robrec/RePeter/Documentation/RF/HT-RA62-Pinmap.png

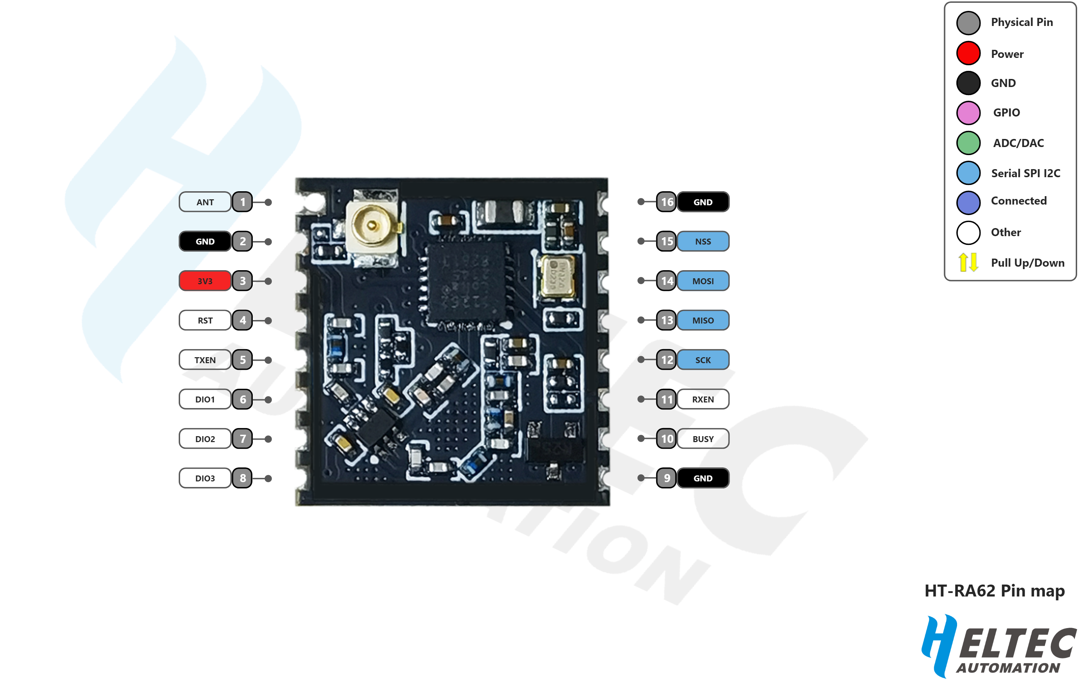
Documentation/RF/HT-RA62-Pinmap.png
