robrec/RePeter/images/RePeterV1_2_Back.png

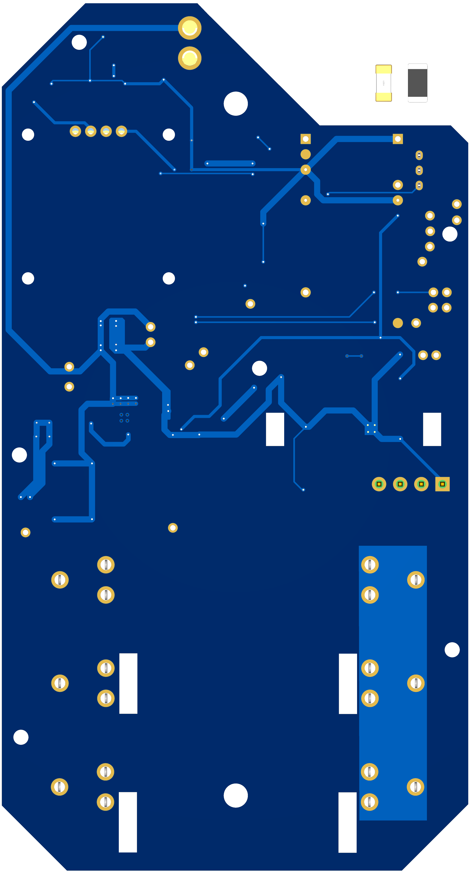
images/RePeterV1_2_Back.png
