robrec/RePeter/images/RePeterV1_2_Front.png

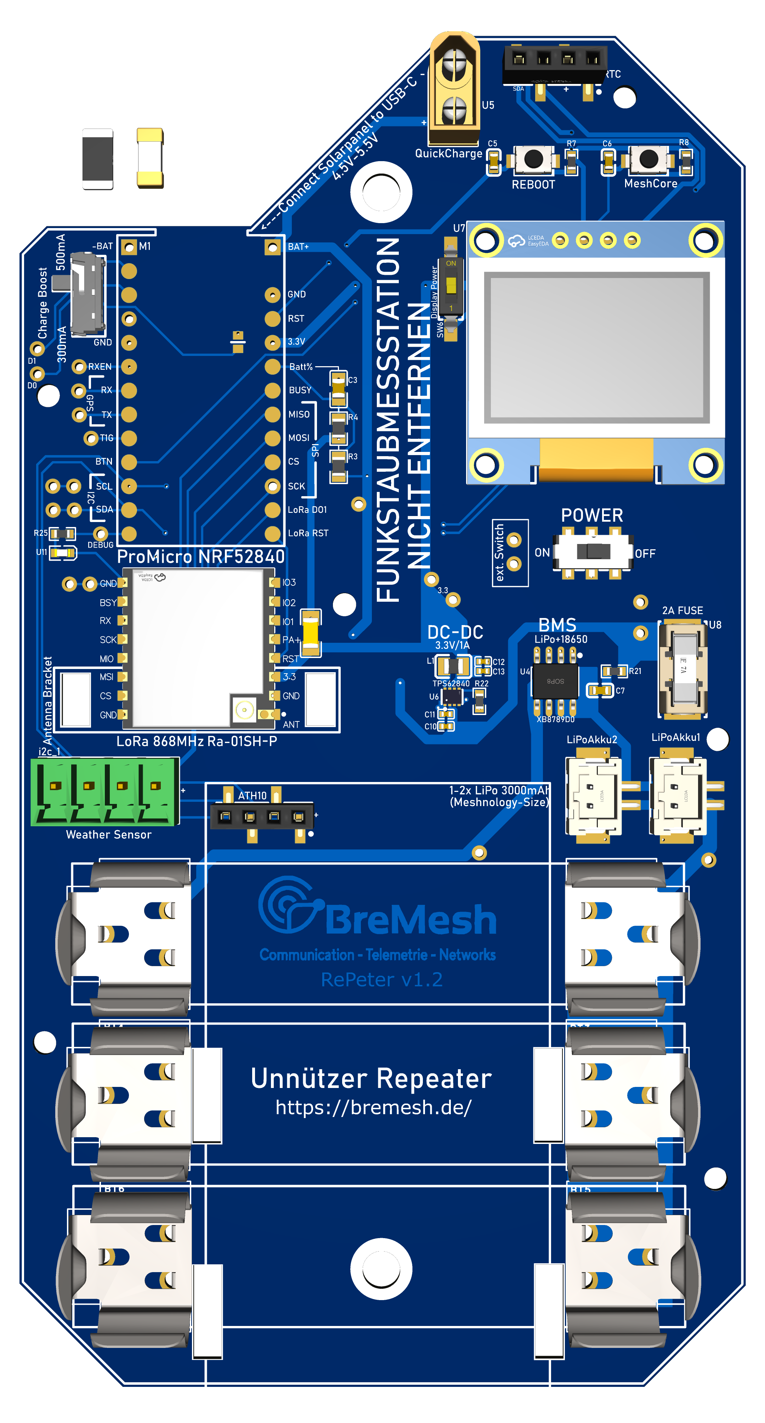
images/RePeterV1_2_Front.png
