robrec/RePeter/images/RePeterV1_2_Front_box.png

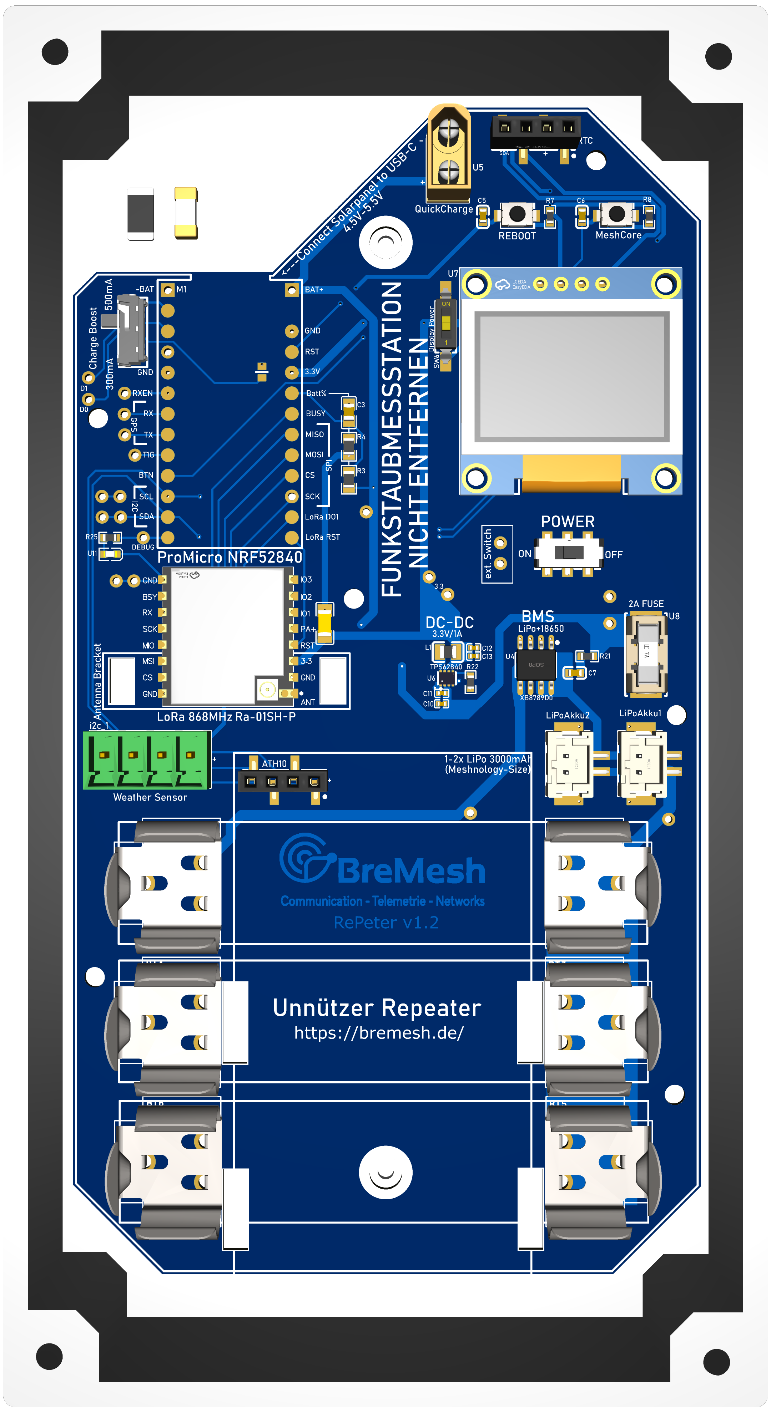
images/RePeterV1_2_Front_box.png
