robrec/RePeter/images/RePeterV1_2_PCBEDITOR.PNG

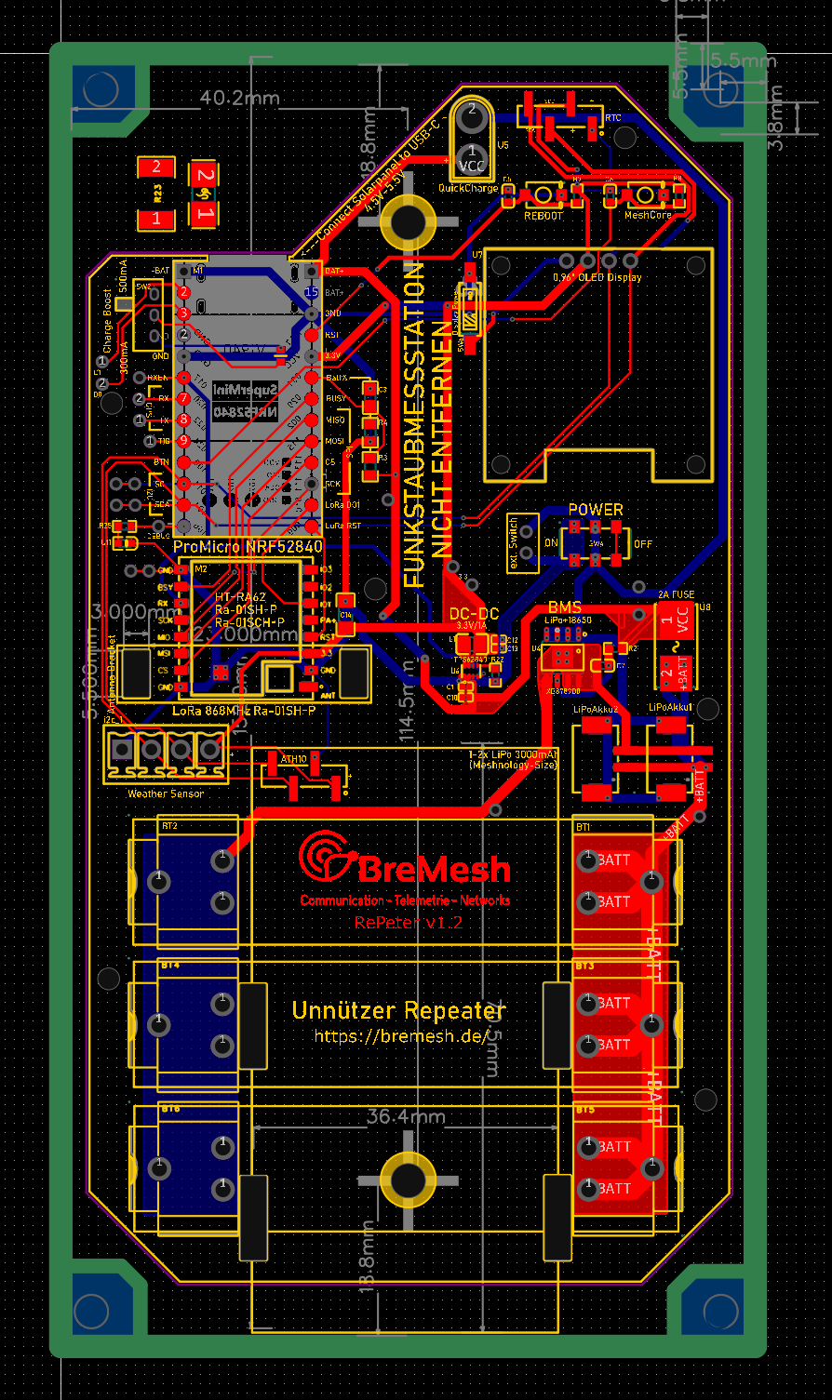
images/RePeterV1_2_PCBEDITOR.PNG
