robrec/RePeter/RePeter_NameTag/RePeter_NameTag_boardV1.PNG

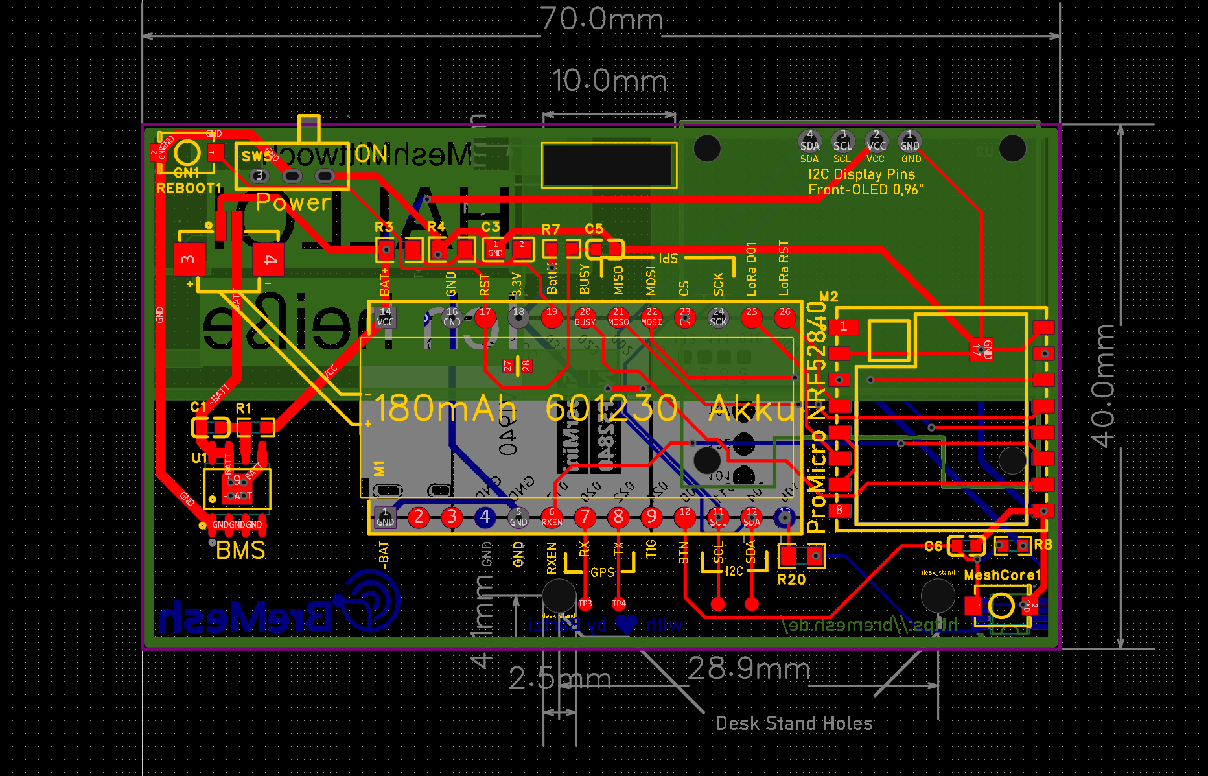
RePeter_NameTag/RePeter_NameTag_boardV1.PNG
