robrec/RePeter/RePeterV1.2/BOM_RePeter_V1.2_FINISHED_RePeterV1.2_2026-01-05.xlsx

No. | Quantity | Comment | Designator | Footprint | Value | Manufacturer Part | Manufacturer | Supplier Part | Supplier
1 | 2 | HX PM2.54-1x4P TP H8.5-YQ | ATH10,RTC | HDR-SMD_4P-P2.54_HX-PM2.54-1X4P-TP-H8.5-YQ |  | HX PM2.54-1x4P TP H8.5-YQ | hanxia(韩下) | C46635840 | LCSC
2 | 6 | MY-18650-01 | BT1,BT2,BT3,BT4,BT5,BT6 | BAT-TH_MY-18650-01 |  | MY-18650-01 | MYOUNG(美阳) | C2979183 | LCSC
3 | 1 | 100nF | C3 | C0805 | 100nF | 0805B104J500NT | FH(风华) | C29926 | LCSC
4 | 3 | 100nF | C5,C6,C7 | C0603 | 100nF | CL10B104KB8NNNC | SAMSUNG(三星) | C1591 | LCSC
5 | 2 | 10uF | C10,C11 | C0402 | 10uF | GRM155R60J106ME15D | muRata(村田) | C412251 | LCSC
6 | 2 | 22uF | C12,C13 | C0402 | 22uF | GRM155R60J226ME11D | muRata(村田) | C415703 | LCSC
7 | 1 | 220uF | C14 | C1206 | 220uF | GRM31CC80G227ME11L | muRata(村田) | C711039 | LCSC
8 | 1 | WJ15EDGVC-3.5-4P | i2c_1 | CONN-TH_WJ15EDGVC-3.5-4P |  | WJ15EDGVC-3.5-4P | KANGNEX(康奈克斯电气) | C5241856 | LCSC
9 | 1 | 2.2uH | L1 | L0806 | 2.2uH | DFE201612E-2R2M=P2 | muRata(村田) | C337893 | LCSC
10 | 2 | PH2.0-2P-LT | LiPoAkku1,LiPoAkku2 | CONN-SMD_PH2.0-1X2PW |  | PH2.0-2P-LT | CAX(创都) | C722761 | LCSC
11 | 1 | ProMicro_nRF52840 | M1 | ProMicro_NRF52840
12 | 1 | Ra-01SH-P/HT-RA62 | M2 | WIRELM-SMD_RA-01SCH-P |  | Ra-01SH-P/HT-RA62 | Ai-Thinker(安信可) | C41368034 | LCSC
13 | 2 | Button | MeshCore,REBOOT | SW-SMD_L3.9-W3.0-P4.45 |  | TS-1088-AR02016 | XUNPU(讯普) | C720477 | LCSC
14 | 2 | 1MΩ | R3,R4 | R0805 | 1MΩ | RT0805BRD071ML | YAGEO(国巨) | C706228 | LCSC
15 | 2 | 10kΩ | R7,R8 | R0603 | 10kΩ | 0603WAF1002T5E | UNI-ROYAL(厚声) | C25804 | LCSC
16 | 1 | 100Ω | R21 | R0603 | 100Ω | RC0603FR-07100RL | YAGEO(国巨) | C105588 | LCSC
17 | 1 | 267kΩ | R22 | R0603 | 267kΩ | 0603WAF2673T5E | UNI-ROYAL(厚声) | C22963 | LCSC
18 | 1 | 0Ω | R23 | RES-SMD_L6.4-W3.2-JER2512XXXXXX | 0Ω | JER2512F3R000 | JIERR(捷而瑞) | C49164931 | LCSC
19 | 1 | 30Ω | R25 | R0603 | 30Ω | 0603WAF300JT5E | UNI-ROYAL(厚声) | C22985 | LCSC
20 | 1 | MK-12D18-G040 | SW2 | SW-TH_MK-12D18-G040 |  | MK-12D18-G040 | G-Switch(品赞) | C963202 | LCSC
21 | 1 | SSSS213202 | SW4 | SW-TH_SSSS213202 |  | SSSS213202 | ALPSALPINE(阿尔卑斯阿尔派) | C115375 | LCSC
22 | 1 | DSIC01LSGET | SW6 | SW-SMD_DSIC01LSGET |  | DSIC01LSGET | YE | C54948 | LCSC
23 | 1 | XB8789D0 | U4 | SOP-8_L4.9-W3.9-P1.27-LS6.0-BL-EP |  | XB8789D0 | xysemi(赛芯微) | C85055 | LCSC
24 | 1 | XT30U-M | U5 | CONN-TH_XT30U-M |  | XT30U-M | AMASS(艾迈斯) | C99101 | LCSC
25 | 1 | TPS62840DLCR | U6 | VSON-8_L2.0-W1.5-P0.50-BL |  | TPS62840DLCR | TI(德州仪器) | C2071859 | LCSC
26 | 1 | HS96L03W2C03 | U7 | OLED-TH_L27.8-W27.2-P2.54_C9900033791 |  | HS96L03W2C03 | HS(汉昇) | C5248080 | LCSC
27 | 1 | 01550900M | U8 | FUSE-SMD_L9.8-W5.0_01550900M |  | 01550900M | Littelfuse(美国力特) | C108518 | LCSC
28 | 1 | 0451002.MRL | U9 | FUSE-SMD_L6.1-W2.7 |  | 0451002.MRL | Littelfuse(美国力特) | C99547 | LCSC
29 | 1 | PSC-1608U52GC-G4 | U11 | LED0603-RD_GREEN |  | PSC-1608U52GC-G4 | HONGLITRONIC(鸿利光电) | C22371297 | LCSC
