robrec/RePeter/RePeter_NameTag/BOM_RePeter_NameTag_RePeter_NameTag_V1_2025-12-26.xlsx

No. | Quantity | Comment | Designator | Footprint | Value | Manufacturer Part | Manufacturer | Supplier Part | Supplier
1 | 1 | 100nF | C1 | C0603 | 100nF | CC0603KRX7R9BB104 | YAGEO(国巨) | C14663 | LCSC
2 | 1 | 100nF | C3 | C0805 | 100nF | 0805B104J500NT | FH(风华) | C29926 | LCSC
3 | 2 | 100nF | C5,C6 | C0603 | 100nF | CL10B104KB8NNNC | SAMSUNG(三星) | C1591 | LCSC
4 | 1 | HC-1.25-2PWT | CN1 | CONN-SMD_2P-P1.25-HC-1.25-2PWT |  | HC-1.25-2PWT | HCTL(华灿天禄) | C2845379 | LCSC
5 | 1 | ProMicro_nRF52840 | M1 | ProMicro_NRF52840
6 | 1 | Ra-01SH-P/HT-62 | M2 | WIRELM-SMD_RA-01SCH-P |  | Ra-01SH-P/HT-62 | Ai-Thinker(安信可) | C41368034 | LCSC
7 | 2 | Button | MeshCore1,REBOOT1 | SW-SMD_L3.9-W3.0-P4.45 |  | TS-1088-AR02016 | XUNPU(讯普) | C720477 | LCSC
8 | 1 | 100Ω | R1 | R0603 | 100Ω | RC0603FR-07100RL | YAGEO(国巨) | C105588 | LCSC
9 | 2 | 1MΩ | R3,R4 | R0805 | 1MΩ | RT0805BRD071ML | YAGEO(国巨) | C706228 | LCSC
10 | 2 | 10kΩ | R7,R8 | R0603 | 10kΩ | 0603WAF1002T5E | UNI-ROYAL(厚声) | C25804 | LCSC
11 | 1 | 5kΩ | R20 | R0805 | 5kΩ | ARG05DTC5001 | Viking(光颉) | C2828783 | LCSC
12 | 1 | MK-12D18-G040 | SW5 | SW-TH_MK-12D18-G040 |  | MK-12D18-G040 | G-Switch(品赞) | C963202 | LCSC
13 | 1 | XB8789D0 | U1 | SOP-8_L4.9-W3.9-P1.27-LS6.0-BL-EP |  | XB8789D0 | xysemi(赛芯微) | C85055 | LCSC
14 | 1 | HS96L03W2C03 | U2 | OLED-TH_L27.8-W27.2-P2.54_C9900033791 |  | HS96L03W2C03 | HS(汉昇) | C5248080 | LCSC
15 | 1 | DS18B20A | U3 | MSOP-8_L3.0-W3.0-P0.65-LS4.9-BR |  | DS18B20A | KTP(科泰普) | C48392933 | LCSC
