robrec/RePeter/RePeter_Tools/ProMicro_ChargeBoard/BOM_USB-C_Adapter_USB-C_RePeter_V1.xlsx

No. | Quantity | Comment | Designator | Footprint | Value | Manufacturer Part | Manufacturer | Supplier Part | Supplier
1 | 1 | PH2.0-2P-LT | JST2.0 | CONN-SMD_PH2.0-1X2PW |  | PH2.0-2P-LT | CAX(创都) | C722761 | LCSC
2 | 1 | TYPEC-303-ACP16 | Solar/Flash | USB-C-SMD_TYPEC-303-ACP16 |  | TYPEC-303-ACP16 | XUNPU(讯普) | C720628 | LCSC
3 | 1 | TC-003LS | toRePeter | USB-C-SMD_TC-003LS |  | TC-003LS | HANBO(汉博) | C6332258 | LCSC
