robrec/RePeter/RePeterV1.2/RePeterV1.2_schematic.pdf

# BUSY 10 RF_EN 11 SCK 12 MISO 13 MOSI 14 NSS 15 GND 16 GND 17

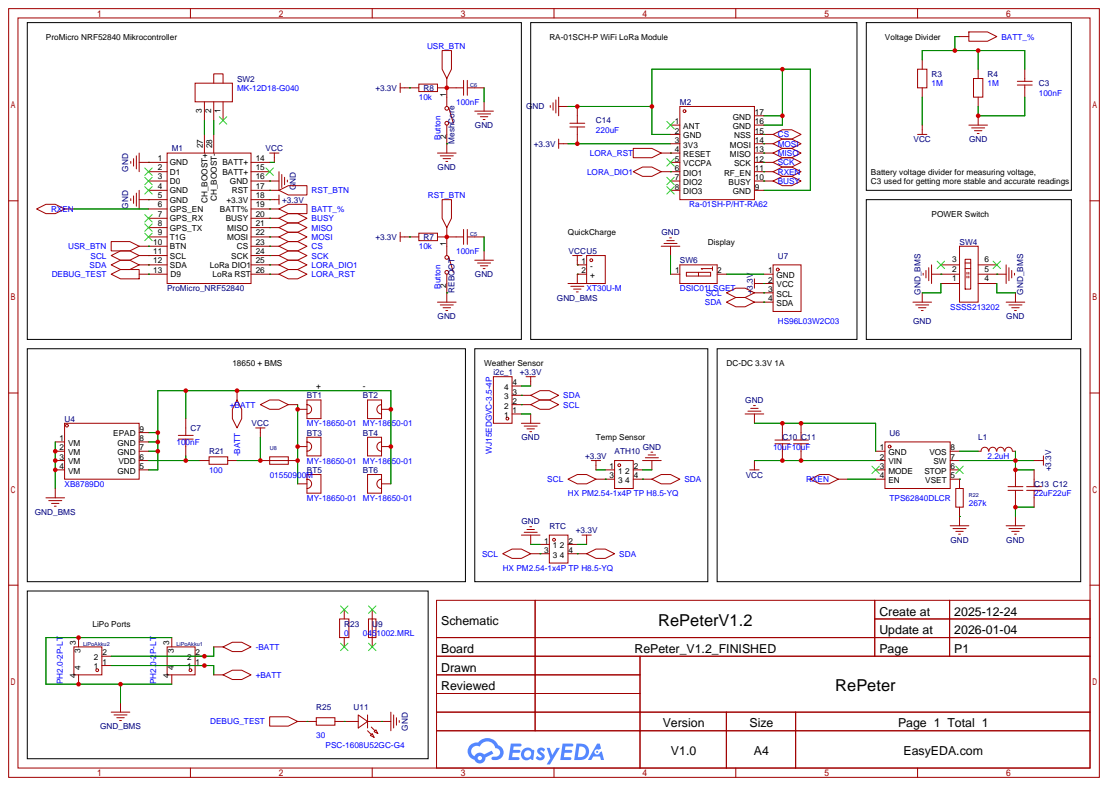
[picture p19: page 1]

Battery voltage divider for measuring voltage,
C3 used for getting more stable and accurate readings

Schematic | RePeterV1.2 | Create at | 2025-12-24

Update at | 2026-01-04

Drawn | RePeter
Reviewed

Version | Size | Page 1 Total 1
V1.0 | A4 | EasyEDA.com
