robrec/RePeter/Documentation/RF/HT-RA62_Reference_design.pdf

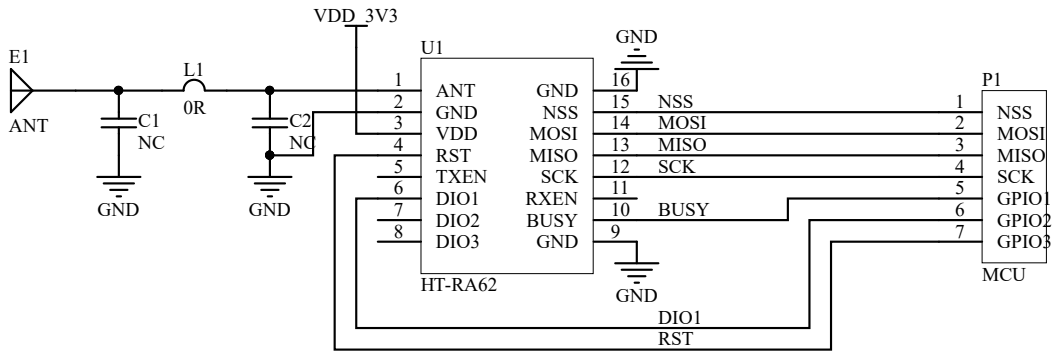
[picture p20: page 1]

NC | | 3 | | 9 BUSY 10 RXEN 11 SCK 12 MISO 13 MOSI 14 NSS 15 GND 16 MOSI 2

4 | | MISO 3
5 | | SCK 4

7 | | BUSY | 6

DIO1 | 7
