robrec/RePeter/Documentation/RF/HT-RA62_Schematic_diagram.pdf

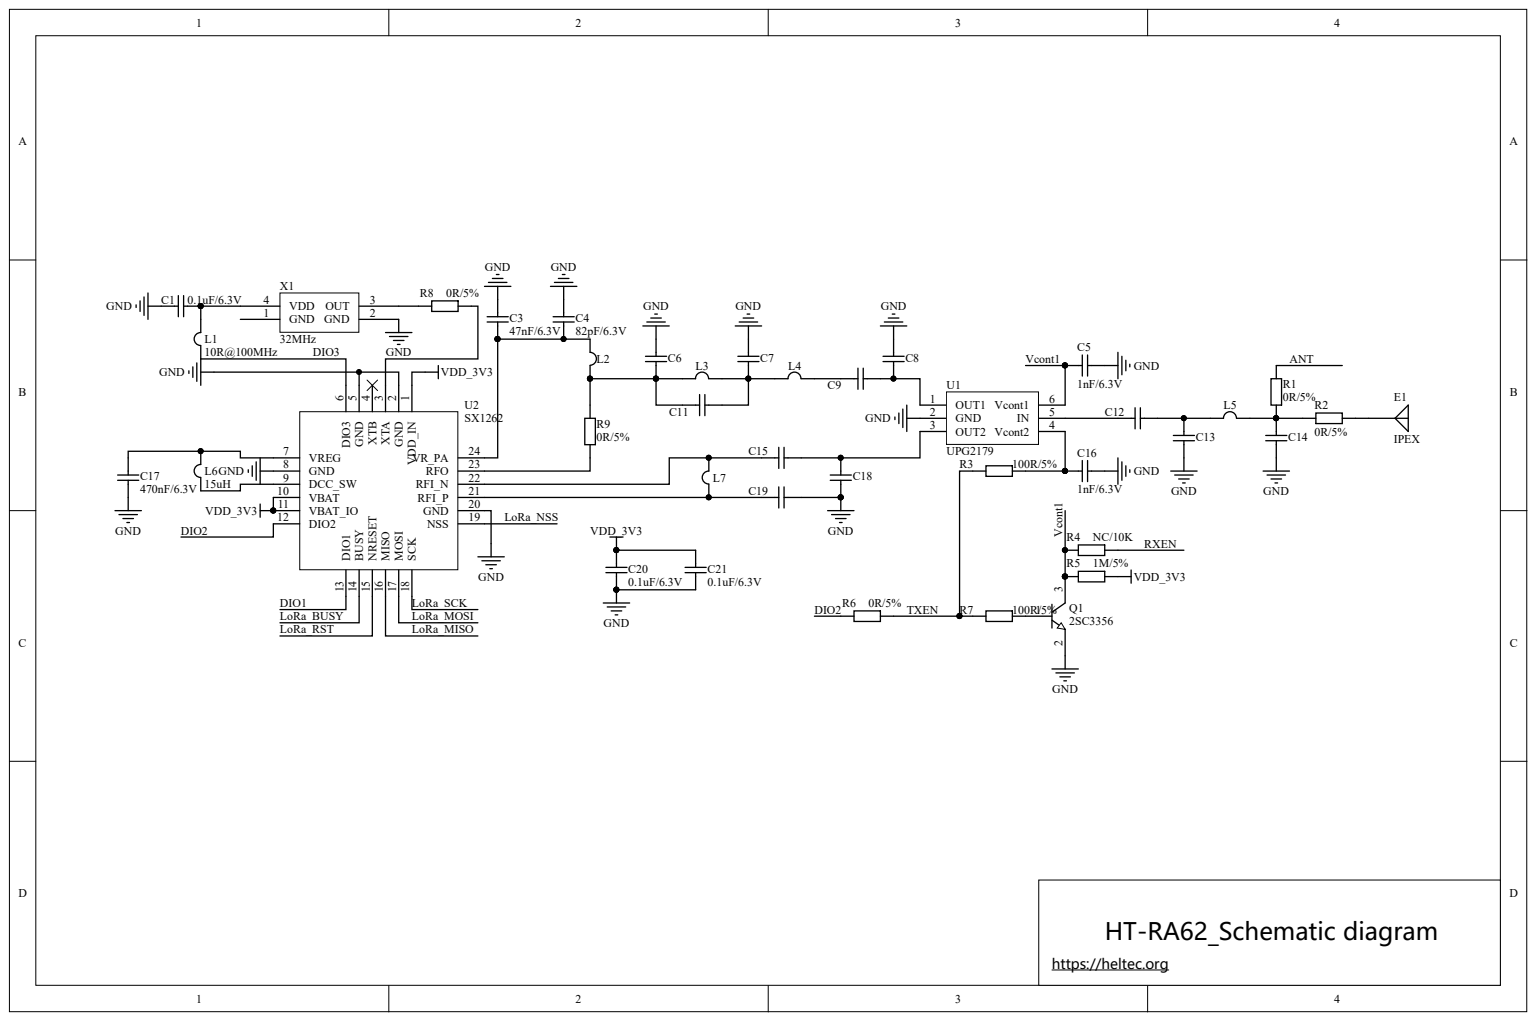
[picture p21: page 1]

VDD_IN 1 GND 2 XTA 3 XTB 4 GND 5 DIO3 6

GND 8 | | L7

VBAT 10 | | C19

DIO1 | | | LoRa_SCK
LoRa_BUSY | | LoRa_MOSI
LoRa_RST | LoRa_MISO
