robrec/RePeter/RePeter_NameTag/SCH_RePeter_NameTag_V1_2025-12-26.pdf

# BUSY 10 RF_EN 11 SCK 12 MISO 13 MOSI 14 NSS 15 GND 16 GND 17

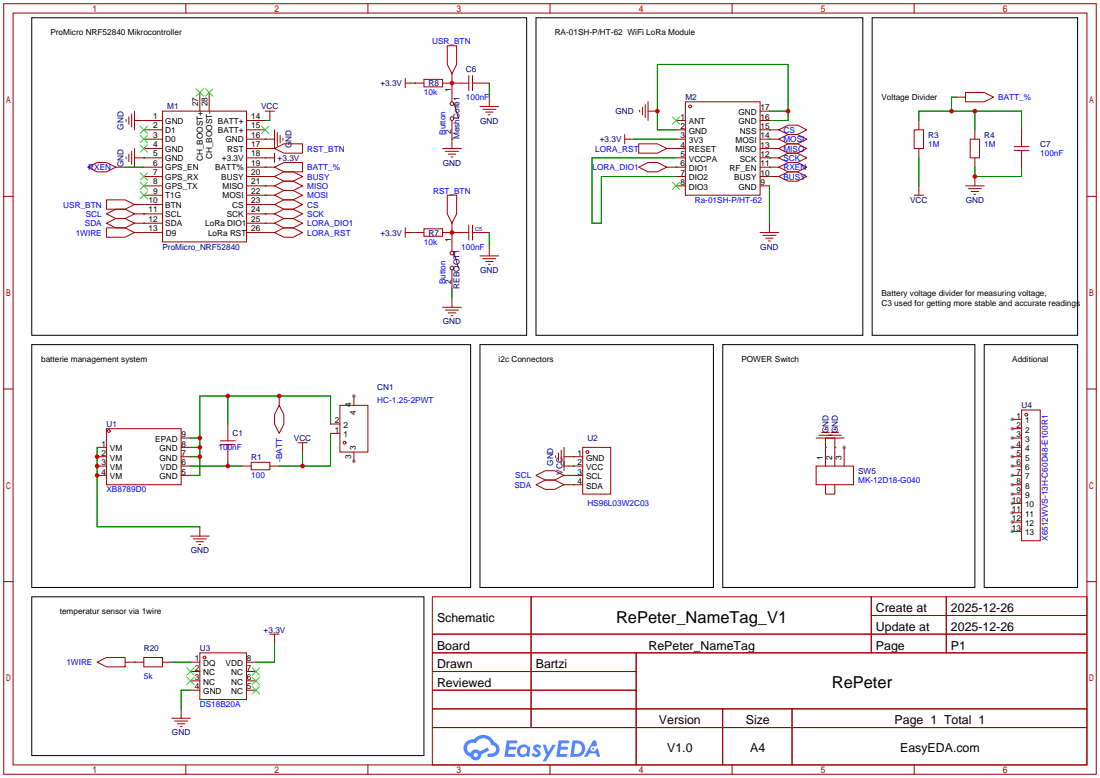
[picture p22: page 1]

Battery voltage divider for measuring voltage,
C3 used for getting more stable and accurate readings

Schematic | RePeter_NameTag_V1 | Create at | 2025-12-26

Update at | 2025-12-26

Board | RePeter_NameTag | Page | P1
Drawn | Bartzi | RePeter
Reviewed

Version | Size | Page 1 Total 1
V1.0 | A4 | EasyEDA.com
