robrec/RePeter/RePeter_Tools/ProMicro_ChargeBoard/SCH_USB-C_RePeter_V1.pdf

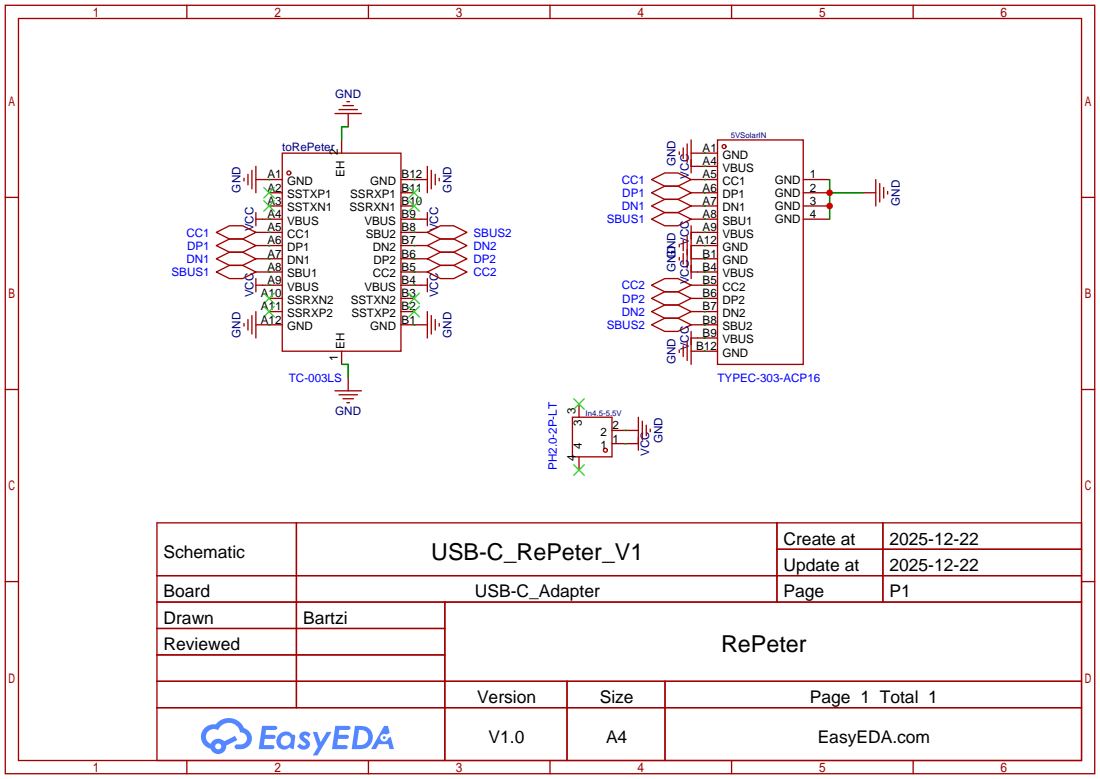
[picture p23: page 1]

GND GND

Schematic | USB-C_RePeter_V1 | Create at | 2025-12-22

Update at | 2025-12-22

Board | USB-C_Adapter | Page | P1
Drawn | Bartzi | RePeter
Reviewed

Version | Size | Page 1 Total 1
V1.0 | A4 | EasyEDA.com
