robrec/RePeter/scripte/PubKeySearcher/key_searcher.py

#!/usr/bin/env python3
"""
BreMesh MeshCore PubKey Searcher
Searches for ed25519 Public Keys with special patterns at the start (HEX)
Utilizes all available CPU cores for maximum performance
"""

import os
import sys
import multiprocessing as mp
import argparse
from datetime import datetime
from pathlib import Path
from typing import Set
import json
import threading
import time

try:
    from cryptography.hazmat.primitives.asymmetric import ed25519
    from cryptography.hazmat.primitives import serialization
    from rich.console import Console, Group
    from rich.panel import Panel
    from rich.table import Table
    from rich.progress import Progress, BarColumn, TextColumn, TaskProgressColumn
    import psutil
except ImportError as e:
    print(f"ERROR: Required library not installed: {e}")
    print("Please install with: pip install cryptography rich psutil")
    exit(1)


class KeySearcher:
    def __init__(self, patterns_file: str = "searchFor.txt", output_dir: str = "found_keys", max_pattern_length: int = 7, single_pattern: str = None, verbose: bool = False):
        self.single_pattern_mode = single_pattern is not None
        self.verbose = verbose
        self.patterns_file = patterns_file  # Store for hot-reload
        if single_pattern:
            self.patterns = {single_pattern.upper()}
            print(f"Searching for single pattern: {single_pattern.upper()}")
        else:
            self.patterns = self.load_patterns(patterns_file)
            print(f"Loaded Patterns: {len(self.patterns)}")
        
        self.output_dir = Path(output_dir)
        self.output_dir.mkdir(exist_ok=True)
        self.max_pattern_length = max_pattern_length
        self.stats_file = Path(".total_stats.json")
        self.total_all_time = self.load_total_stats()
        
        print(f"Output Directory: {self.output_dir.absolute()}")
        print(f"Max Pattern Length for Duplicate Prevention: {self.max_pattern_length}")
        print(f"Total Keys Checked All-Time: {self.total_all_time:,}")
    
    def load_patterns(self, filename: str) -> Set[str]:
        """Loads patterns from file"""
        patterns = set()
        try:
            with open(filename, 'r', encoding='utf-8') as f:
                for line in f:
                    line = line.strip()
                    if line and not line.startswith('#'):
                        patterns.add(line)
        except FileNotFoundError:
            print(f"ERROR: {filename} not found!")
            exit(1)
        return patterns
    
    def load_total_stats(self) -> int:
        """Loads total all-time key count from stats file"""
        try:
            if self.stats_file.exists():
                with open(self.stats_file, 'r', encoding='utf-8') as f:
                    data = json.load(f)
                    return data.get('total_keys_checked', 0)
        except Exception:
            pass
        return 0
    
    def save_total_stats(self, total_keys: int) -> None:
        """Saves total all-time key count to stats file"""
        try:
            data = {
                'total_keys_checked': self.total_all_time + total_keys,
                'last_updated': datetime.now().isoformat()
            }
            with open(self.stats_file, 'w', encoding='utf-8') as f:
                json.dump(data, f, indent=2)
        except Exception:
            pass
    
    @staticmethod
    def format_number(num: int) -> str:
        """Format number with k/M suffix"""
        if num >= 1_000_000:
            return f"{num / 1_000_000:.1f}M"
        elif num >= 1_000:
            return f"{num / 1_000:.1f}k"
        return str(num)
    
    @staticmethod
    def format_time(seconds: float) -> str:
        """Format seconds to readable time string"""
        if seconds < 60:
            return f"{int(seconds)}s"
        elif seconds < 3600:
            return f"{int(seconds / 60)}m"
        elif seconds < 86400:
            return f"{seconds / 3600:.1f}h"
        elif seconds < 31536000:
            return f"{seconds / 86400:.1f}d"
        return f"{seconds / 31536000:.1f}y"
    
    @staticmethod
    def estimate_time(pattern_length: int, keys_per_sec: int) -> str:
        """Estimate time to find a pattern of given length"""
        if keys_per_sec == 0:
            return "N/A"
        possibilities = 16 ** pattern_length
        seconds = possibilities / keys_per_sec
        return KeySearcher.format_time(seconds)
    
    @staticmethod
    def display_process(display_queue, total_all_time, start_time, num_workers, pause_event, cpu_limit_event, startup_info):
        """Dedicated process for displaying live statistics using Rich Live"""
        from rich.live import Live
        
        console = Console()
        last_total = 0
        last_found = 0
        found_keys_list = []
        is_paused = False
        # Track found patterns by length category - start with existing counts
        found_by_len = {k: v for k, v in startup_info['existing_counts'].items()}
        # Track remaining pattern lengths for ETA calculation
        remaining_lengths = list(startup_info['remaining_pattern_lengths'])
        last_find_time = start_time  # Time of last found key (or start)
        
        def build_panel():
            """Build the combined stats panel"""
            nonlocal is_paused
            is_paused = not pause_event.is_set()
            
            elapsed = max(0.1, datetime.now().timestamp() - start_time)
            cpu_percent = psutil.cpu_percent(interval=0.1)
            keys_per_sec = int(last_total / elapsed) if elapsed > 0 else 0
            all_time_total = total_all_time + last_total
            
            content = Table.grid(padding=(0, 2))
            content.add_column(justify="right", style="bright_cyan")
            content.add_column(justify="left", style="bright_white")
            content.add_column(justify="right", style="bright_cyan")
            content.add_column(justify="left", style="bright_white")
            
            # Config section
            is_cpu_limited = cpu_limit_event.is_set()
            workers_text = f"[bold cyan]{num_workers}[/bold cyan]"
            if is_cpu_limited:
                workers_paused = max(1, int(num_workers * 0.25))
                workers_active = num_workers - workers_paused
                workers_text = f"[bold cyan]{num_workers}[/bold cyan] [dim yellow](Limit: {workers_active})[/dim yellow]"
            
            content.add_row(
                "[bold bright_cyan]Patterns:[/bold bright_cyan]", f"[bold green]{startup_info['num_patterns']}[/bold green]",
                "[bold bright_cyan]Workers:[/bold bright_cyan]", workers_text
            )
            if startup_info['existing_patterns']:
                content.add_row(
                    "[bold bright_cyan]Already Found:[/bold bright_cyan]", f"[bold yellow]{startup_info['num_existing']}[/bold yellow]",
                    "", ""
                )
            content.add_row(
                "[bold bright_cyan]No Dup Cap:[/bold bright_cyan]", f"[dim]>{startup_info['max_pattern_length']} chars[/dim]",
                "", ""
            )
            
            # Separator
            content.add_row("[dim]" + "─" * 40 + "[/dim]", "", "", "")
            
            # Status
            is_cpu_limited = cpu_limit_event.is_set()
            if is_paused:
                status = "[bold yellow]⏸ PAUSED[/bold yellow]"
            else:
                status = "[bold green]▶ RUNNING[/bold green]"
                if is_cpu_limited:
                    workers_paused = max(1, int(num_workers * 0.25))
                    workers_active = num_workers - workers_paused
                    target_pct = int((workers_active / num_workers) * 100)
                    status += f" [dim yellow](CPU ~{target_pct}%)[/dim yellow]"
            content.add_row("[bold bright_cyan]Status:[/bold bright_cyan]", status, "", "")
            
            # Stats
            content.add_row(
                "[bold bright_cyan]Session:[/bold bright_cyan]", f"[bold green]{KeySearcher.format_number(last_total)}[/bold green] keys",
                "[bold bright_cyan]All-Time:[/bold bright_cyan]", f"[bold blue]{KeySearcher.format_number(all_time_total)}[/bold blue] keys"
            )
            content.add_row(
                "[bold bright_cyan]Found:[/bold bright_cyan]", f"[bold yellow]{last_found}[/bold yellow] matches",
                "[bold bright_cyan]Speed:[/bold bright_cyan]", f"[bold magenta]{KeySearcher.format_number(keys_per_sec)}[/bold magenta] keys/s"
            )
            
            # CPU bar with better visuals
            bar_width = 20
            filled = int(cpu_percent / 100 * bar_width)
            bar = "█" * filled + "░" * (bar_width - filled)
            bar_color = "red" if cpu_percent > 80 else ("yellow" if cpu_percent > 50 else "green")
            content.add_row(
                "[bold bright_cyan]Duration:[/bold bright_cyan]", f"[bold white]{KeySearcher.format_time(elapsed)}[/bold white]",
                "[bold bright_cyan]CPU:[/bold bright_cyan]", f"[{bar_color}]{bar}[/{bar_color}] [bold white]{cpu_percent:.0f}%[/bold white]"
            )
            
            # Rarity colors by pattern length
            COLOR_ARTIFACT = "#FF8000"   # 10+ chars - Orange
            COLOR_EPIC = "#A335EE"       # 9 chars - Purple
            COLOR_RARE = "#0070DD"       # 8 chars - Blue
            COLOR_UNCOMMON = "#1EFF00"   # 7 chars - Green
            COLOR_COMMON = "#FFFFFF"     # 6 chars - White
            COLOR_POOR = "#9D9D9D"       # <=5 chars - Gray
            
            # Remaining patterns to find (total and by length)
            # found_by_len already includes existing + session found
            total_found = sum(found_by_len.values())
            remaining = startup_info['num_patterns'] - total_found
            pc = startup_info['pattern_counts']
            # Format: found/total for each category
            fbl = found_by_len
            
            # Estimates section
            content.add_row("", "", "", "")
            content.add_row("[dim]" + "─" * 40 + "[/dim]", "", "", "")
            content.add_row(
                "[bold bright_yellow]Time Estimates:[/bold bright_yellow]", "",
                "[bold bright_cyan]Remaining:[/bold bright_cyan]", f"[bold white]{remaining}[/bold white] patterns"
            )
            content.add_row(
                "[dim]  5 chars:[/dim]", f"[{COLOR_POOR}]{KeySearcher.estimate_time(5, keys_per_sec)}[/{COLOR_POOR}]  [dim]({fbl[5]}/{pc[5]})[/dim]",
                "[dim]  6 chars:[/dim]", f"[{COLOR_COMMON}]{KeySearcher.estimate_time(6, keys_per_sec)}[/{COLOR_COMMON}]  [dim]({fbl[6]}/{pc[6]})[/dim]"
            )
            content.add_row(
                "[dim]  7 chars:[/dim]", f"[{COLOR_UNCOMMON}]{KeySearcher.estimate_time(7, keys_per_sec)}[/{COLOR_UNCOMMON}]  [dim]({fbl[7]}/{pc[7]})[/dim]",
                "[dim]  8 chars:[/dim]", f"[{COLOR_RARE}]{KeySearcher.estimate_time(8, keys_per_sec)}[/{COLOR_RARE}]  [dim]({fbl[8]}/{pc[8]})[/dim]"
            )
            content.add_row(
                "[dim]  9 chars:[/dim]", f"[{COLOR_EPIC}]{KeySearcher.estimate_time(9, keys_per_sec)}[/{COLOR_EPIC}]  [dim]({fbl[9]}/{pc[9]})[/dim]",
                "[dim]  10+ chars:[/dim]", f"[{COLOR_ARTIFACT}]{KeySearcher.estimate_time(10, keys_per_sec)}[/{COLOR_ARTIFACT}]  [dim]({fbl[10]}/{pc[10]})[/dim]"
            )
            
            # Build main panel
            main_panel = Panel(
                content,
                title="[bold bright_white on blue] 🔍 BreMesh MeshCore Ed25519 PubKey Prefix Searcher [/bold bright_white on blue]",
                subtitle="[dim white]Ctrl+C to stop • P to pause • R to resume • L to limit CPU[/dim white]",
                border_style="bright_blue",
                padding=(1, 2)
            )
            
            # Calculate ETA for next key based on remaining patterns
            # Combined probability = sum(1/16^L for each remaining pattern)
            progress_panel = None  # Default: no progress panel
            if keys_per_sec > 0 and remaining_lengths:
                combined_prob = sum(1.0 / (16 ** plen) for plen in remaining_lengths)
                if combined_prob > 0:
                    expected_keys = 1.0 / combined_prob
                    expected_seconds = expected_keys / keys_per_sec
                    time_since_last = datetime.now().timestamp() - last_find_time
                    
                    # Session expected: how many keys should we have found by now?
                    session_elapsed = datetime.now().timestamp() - start_time
                    session_expected_keys = session_elapsed * keys_per_sec * combined_prob
                    
                    # Progress: time since last find / expected time per key
                    # Resets to 0 when a key is found, grows towards 100%
                    progress = (time_since_last / expected_seconds) if expected_seconds > 0 else 0
                    
                    # Bar is capped at 0-100%, but percentage display can go outside
                    bar_progress = max(0.0, min(1.0, progress))
                    
                    # Color changes based on progress
                    if progress < 0.5:
                        bar_color = "bright_cyan"
                    elif progress < 1.0:
                        bar_color = "bright_yellow"
                    else:
                        bar_color = "bright_green"  # Overdue - should find soon!
                    
                    eta_str = KeySearcher.format_time(expected_seconds)
                    elapsed_str = KeySearcher.format_time(time_since_last)
                    percent_str = f"{progress * 100:.0f}%"
                    
                    # Dynamic progress bar - use console width minus panel padding/border
                    terminal_width = console.size.width
                    bar_width = max(20, terminal_width - 8)  # -8 for panel borders and padding
                    filled = int(bar_progress * bar_width)  # Bar capped at 100%
                    
                    # Build progress bar with percentage in the middle
                    center_pos = bar_width // 2 - len(percent_str) // 2
                    bar_chars = []
                    for i in range(bar_width):
                        if i >= center_pos and i < center_pos + len(percent_str):
                            # Character from percent string
                            char_idx = i - center_pos
                            char = percent_str[char_idx]
                            if i < filled:
                                bar_chars.append(f"[bold black on {bar_color}]{char}[/bold black on {bar_color}]")
                            else:
                                bar_chars.append(f"[bold {bar_color}]{char}[/bold {bar_color}]")
                        else:
                            # Bar character
                            if i < filled:
                                bar_chars.append(f"[{bar_color}]█[/{bar_color}]")
                            else:
                                bar_chars.append("[dim]░[/dim]")
                    
                    progress_bar = "".join(bar_chars)
                    
                    # Build per-length ETA timers with rarity colors
                    from collections import Counter
                    len_counts = Counter(remaining_lengths)
                    eta_timers = []
                    # Collect counts for 11+ separately
                    count_11_plus = sum(c for l, c in len_counts.items() if l >= 11)
                    for length in sorted(len_counts.keys()):
                        if length > 10:
                            continue  # Skip individual lengths > 10, handled as 11+
                        count = len_counts[length]
                        if count > 0 and keys_per_sec > 0:
                            prob = count / (16 ** length)
                            eta_secs = 1.0 / (prob * keys_per_sec)
                            # Color based on length
                            if length >= 10:
                                color = COLOR_ARTIFACT
                            elif length == 9:
                                color = COLOR_EPIC
                            elif length == 8:
                                color = COLOR_RARE
                            elif length == 7:
                                color = COLOR_UNCOMMON
                            elif length == 6:
                                color = COLOR_COMMON
                            else:
                                color = COLOR_POOR
                            eta_timers.append(f"[dim]{length}:[/dim][{color}]{KeySearcher.format_time(eta_secs)}[/{color}]")
                    # Add 11+ in red if there are any patterns >= 11
                    if count_11_plus > 0 and keys_per_sec > 0:
                        prob_11 = count_11_plus / (16 ** 11)
                        eta_secs_11 = 1.0 / (prob_11 * keys_per_sec)
                        eta_timers.append(f"[dim]11+:[/dim][bold red]{KeySearcher.format_time(eta_secs_11)}[/bold red]")
                    eta_timers_str = "  ".join(eta_timers) if eta_timers else ""
                    
                    # Progress panel content with expected vs found keys
                    expected_found_str = f"[dim]Session:[/dim] [bold white]{last_found}[/bold white] [dim]/[/dim] [bold yellow]{session_expected_keys:.2f}[/bold yellow]"
                    progress_text = f"[bold bright_magenta]Next Key ETA:[/bold bright_magenta] [bold white]{eta_str}[/bold white]    [dim]Elapsed:[/dim] [dim white]{elapsed_str}[/dim white]    {expected_found_str}    {eta_timers_str}\n{progress_bar}"
                    
                    # Show formula only in verbose mode
                    if startup_info.get('verbose', False):
                        formula_parts = []
                        for length in sorted(len_counts.keys()):
                            count = len_counts[length]
                            formula_parts.append(f"{count}/16^{length}")
                        formula_str = f"[dim]ETA = 1 / (({' + '.join(formula_parts)}) × {KeySearcher.format_number(keys_per_sec)}) = {eta_str}[/dim]"
                        progress_text += f"\n{formula_str}"
                    
                    progress_panel = Panel(
                        progress_text,
                        border_style="bright_magenta",
                        padding=(0, 2)
                    )
                    
                    # Build found keys panel (third panel)
                    if found_keys_list:
                        found_content = Table.grid(padding=(0, 2))
                        found_content.add_column(justify="left")
                        found_content.add_column(justify="left")
                        
                        for pattern, preview in found_keys_list[-5:]:
                            pattern_len = len(pattern)
                            # Rarity indicators based on pattern length
                            if pattern_len >= 11:
                                symbol = "[bold red]***[/bold red]"
                                pattern_style = "[bold red]"
                                end_style = "[/bold red]"
                            elif pattern_len >= 10:
                                symbol = f"[{COLOR_ARTIFACT}]**[/{COLOR_ARTIFACT}]"
                                pattern_style = f"[bold {COLOR_ARTIFACT}]"
                                end_style = f"[/bold {COLOR_ARTIFACT}]"
                            elif pattern_len >= 9:
                                symbol = f"[{COLOR_EPIC}]*[/{COLOR_EPIC}]"
                                pattern_style = f"[bold {COLOR_EPIC}]"
                                end_style = f"[/bold {COLOR_EPIC}]"
                            elif pattern_len >= 8:
                                symbol = f"[{COLOR_RARE}]+[/{COLOR_RARE}]"
                                pattern_style = f"[bold {COLOR_RARE}]"
                                end_style = f"[/bold {COLOR_RARE}]"
                            elif pattern_len >= 7:
                                symbol = f"[{COLOR_UNCOMMON}]•[/{COLOR_UNCOMMON}]"
                                pattern_style = f"[{COLOR_UNCOMMON}]"
                                end_style = f"[/{COLOR_UNCOMMON}]"
                            elif pattern_len >= 6:
                                symbol = f"[{COLOR_COMMON}]•[/{COLOR_COMMON}]"
                                pattern_style = f"[{COLOR_COMMON}]"
                                end_style = f"[/{COLOR_COMMON}]"
                            else:
                                symbol = f"[{COLOR_POOR}]•[/{COLOR_POOR}]"
                                pattern_style = f"[{COLOR_POOR}]"
                                end_style = f"[/{COLOR_POOR}]"
                            
                            padded_pattern = pattern.ljust(16)
                            found_content.add_row(
                                f"{symbol} {pattern_style}{padded_pattern}{end_style}", 
                                f"[dim]{preview}[/dim]"
                            )
                        
                        found_panel = Panel(
                            found_content,
                            title=f"[bold green]🔑 Found Keys ({len(found_keys_list)})[/bold green]",
                            border_style="green",
                            padding=(0, 2)
                        )
                        
                        return Group(main_panel, progress_panel, found_panel)
                    
                    return Group(main_panel, progress_panel)
            
            # No progress panel case (keys_per_sec == 0 or no remaining patterns)
            if found_keys_list:
                found_content = Table.grid(padding=(0, 2))
                found_content.add_column(justify="left")
                found_content.add_column(justify="left")
                
                for pattern, preview in found_keys_list[-5:]:
                    pattern_len = len(pattern)
                    if pattern_len >= 11:
                        symbol = "[bold red]***[/bold red]"
                        pattern_style = "[bold red]"
                        end_style = "[/bold red]"
                    elif pattern_len >= 10:
                        symbol = f"[{COLOR_ARTIFACT}]**[/{COLOR_ARTIFACT}]"
                        pattern_style = f"[bold {COLOR_ARTIFACT}]"
                        end_style = f"[/bold {COLOR_ARTIFACT}]"
                    elif pattern_len >= 9:
                        symbol = f"[{COLOR_EPIC}]*[/{COLOR_EPIC}]"
                        pattern_style = f"[bold {COLOR_EPIC}]"
                        end_style = f"[/bold {COLOR_EPIC}]"
                    elif pattern_len >= 8:
                        symbol = f"[{COLOR_RARE}]+[/{COLOR_RARE}]"
                        pattern_style = f"[bold {COLOR_RARE}]"
                        end_style = f"[/bold {COLOR_RARE}]"
                    elif pattern_len >= 7:
                        symbol = f"[{COLOR_UNCOMMON}]•[/{COLOR_UNCOMMON}]"
                        pattern_style = f"[{COLOR_UNCOMMON}]"
                        end_style = f"[/{COLOR_UNCOMMON}]"
                    elif pattern_len >= 6:
                        symbol = f"[{COLOR_COMMON}]•[/{COLOR_COMMON}]"
                        pattern_style = f"[{COLOR_COMMON}]"
                        end_style = f"[/{COLOR_COMMON}]"
                    else:
                        symbol = f"[{COLOR_POOR}]•[/{COLOR_POOR}]"
                        pattern_style = f"[{COLOR_POOR}]"
                        end_style = f"[/{COLOR_POOR}]"
                    
                    padded_pattern = pattern.ljust(16)
                    found_content.add_row(
                        f"{symbol} {pattern_style}{padded_pattern}{end_style}", 
                        f"[dim]{preview}[/dim]"
                    )
                
                found_panel = Panel(
                    found_content,
                    title=f"[bold green]🔑 Found Keys ({len(found_keys_list)})[/bold green]",
                    border_style="green",
                    padding=(0, 2)
                )
                
                return Group(main_panel, found_panel)
            
            return main_panel
        
        try:
            # Use Live with screen=True for flicker-free updates
            with Live(build_panel(), console=console, screen=True, refresh_per_second=4) as live:
                while True:
                    try:
                        msg = display_queue.get(timeout=0.5)
                        
                        if msg == 'STOP':
                            break
                        
                        if isinstance(msg, dict):
                            if msg.get('force_update'):
                                live.update(build_panel())
                                continue
                            
                            # Handle pattern hot-reload notification
                            if msg.get('patterns_reloaded'):
                                startup_info['num_patterns'] = msg['new_count']
                                # Add new patterns to remaining_lengths (assuming average length)
                                for _ in range(msg['added']):
                                    remaining_lengths.append(7)  # Default assumption for new patterns
                                live.update(build_panel())
                                continue
                            
                            last_total = msg.get('total', last_total)
                            last_found = msg.get('found', last_found)
                            
                            if 'new_key' in msg:
                                found_keys_list.append((msg['new_key']['pattern'], msg['new_key']['public_key']))
                                # Update found count by length
                                plen = len(msg['new_key']['pattern'])
                                if plen <= 5:
                                    found_by_len[5] += 1
                                elif plen >= 10:
                                    found_by_len[10] += 1
                                else:
                                    found_by_len[plen] += 1
                                # Remove pattern from remaining ONLY if it's <= max_pattern_length
                                # Patterns > max_pattern_length can be found multiple times
                                if plen <= startup_info['max_pattern_length'] and plen in remaining_lengths:
                                    remaining_lengths.remove(plen)
                                # Reset last_find_time to now (for Elapsed timer)
                                last_find_time = datetime.now().timestamp()
                            
                            live.update(build_panel())
                    
                    except Exception:
                        # Timeout - auto refresh
                        live.update(build_panel())
        
        except KeyboardInterrupt:
            pass
    
    def generate_and_check_key(self, worker_id: int, shared_counter, shared_found,
                                found_patterns_dict, session_found_list, shared_patterns, start_time,
                                display_queue, pause_event, stop_event, worker_pause_event, single_pattern_mode) -> None:
        """Worker process for key generation"""
        local_checked = 0
        local_patterns_cache = set(shared_patterns.keys())  # Local cache for performance
        last_cache_update = 0
        
        try:
            while not stop_event.is_set():
                # Main wait for pause/resume
                pause_event.wait()
                # Worker-specific pause (for CPU limiting)
                worker_pause_event.wait()
                
                if stop_event.is_set():
                    break
                
                # Refresh pattern cache every 10000 keys
                local_checked_total = local_checked
                if local_checked_total - last_cache_update >= 10000:
                    local_patterns_cache = set(shared_patterns.keys())
                    last_cache_update = local_checked_total
                
                private_key = ed25519.Ed25519PrivateKey.generate()
                public_key = private_key.public_key()
                
                public_bytes = public_key.public_bytes(
                    encoding=serialization.Encoding.Raw,
                    format=serialization.PublicFormat.Raw
                )
                public_hex = public_bytes.hex().upper()
                
                private_bytes = private_key.private_bytes(
                    encoding=serialization.Encoding.Raw,
                    format=serialization.PrivateFormat.Raw,
                    encryption_algorithm=serialization.NoEncryption()
                )
                
                for pattern in local_patterns_cache:
                    if public_hex.startswith(pattern):
                        if len(pattern) <= self.max_pattern_length:
                            if pattern in found_patterns_dict:
                                continue
                            found_patterns_dict[pattern] = True
                            session_found_list.append(pattern)
                        
                        self.save_key(private_bytes, public_bytes, public_hex, pattern)
                        
                        with shared_found.get_lock():
                            shared_found.value += 1
                        
                        # All workers send new_key message
                        display_queue.put({
                            'total': shared_counter.value,
                            'found': shared_found.value,
                            'new_key': {'pattern': pattern, 'public_key': public_hex}
                        })
                        
                        # In single pattern mode, signal all workers to stop
                        if single_pattern_mode:
                            stop_event.set()
                        break
                
                local_checked += 1
                
                if local_checked % 1000 == 0:
                    with shared_counter.get_lock():
                        shared_counter.value += 1000
                
                if worker_id == 0 and local_checked % 10000 == 0:
                    total = shared_counter.value
                    display_queue.put({'total': total, 'found': shared_found.value})
                    
                    if total % 1000000 < 10000:
                        self.save_total_stats(total)
        
        except KeyboardInterrupt:
            return
    
    def save_key(self, private_bytes: bytes, public_bytes: bytes, public_hex: str, pattern: str) -> None:
        """Save found key to file"""
        # Always use counter format: pattern_1.txt, pattern_2.txt, etc.
        counter = 1
        filepath = self.output_dir / f"{pattern}_{counter}.txt"
        while filepath.exists():
            counter += 1
            filepath = self.output_dir / f"{pattern}_{counter}.txt"
        
        # Standard Ed25519 format (128 chars)
        private_hex_standard = private_bytes.hex().upper()
        # MeshCore format (192 chars: private + public)
        private_hex_meshcore = (private_bytes + public_bytes).hex().upper()
        
        with open(filepath, 'w', encoding='utf-8') as f:
            f.write(f"Pattern Match: {pattern}\n")
            f.write(f"Public Key (HEX): {public_hex}\n\n")
            f.write(f"# Standard Ed25519 Format (128 characters)\n")
            f.write(f"# This is the pure private key as generated by the Ed25519 algorithm\n")
            f.write(f"Private Key (Standard): {private_hex_standard}\n\n")
            f.write(f"# MeshCore Format (192 characters)\n")
            f.write(f"# This format concatenates the private key (128 chars) with the public\n")
            f.write(f"# key (64 chars) for convenience. Use this format for MeshCore devices.\n")
            f.write(f"Private Key (MeshCore): {private_hex_meshcore}\n")
            f.write(f"\n{'='*70}\n")
            f.write(f"MeshCore Import Format:\n")
            f.write(f"{'='*70}\n\n")
            f.write('{\n')
            f.write(f'  "public_key": "{public_hex}",\n')
            f.write(f'  "private_key": "{private_hex_meshcore}"\n')
            f.write('}\n')
            f.write(f"\n{'='*70}\n")
            f.write(f"Repeater Configuration Instructions\n")
            f.write(f"{'='*70}\n\n")
            f.write("METHOD 1: Repeater + Computer (USB Serial)\n")
            f.write("-" * 70 + "\n")
            f.write("If you can connect your repeater directly to a computer, this is the\n")
            f.write("fastest method:\n\n")
            f.write("1. Connect via USB Serial\n")
            f.write("   Connect your repeater device to your computer via USB serial connection.\n\n")
            f.write("2. Access the Console\n")
            f.write("   Open the MeshCore Web Console or use any terminal application to\n")
            f.write("   connect to your device.\n\n")
            f.write("   Tip: The web console at flasher.meshcore.co.uk provides an easy\n")
            f.write("   interface with repeater configuration command reference.\n\n")
            f.write("3. Set the Private Key\n")
            f.write("   Run the following command in the console:\n\n")
            f.write(f"   set prv.key {private_hex_meshcore}\n\n")
            f.write("   Important: Make sure to use the complete 192-character MeshCore format\n")
            f.write("   private key. The command will change the device's private key immediately.\n\n")
            f.write("4. Verify the Change\n")
            f.write("   You can verify the key change by checking the device's public key\n")
            f.write("   display in settings.\n\n")
            f.write("Why use the Serial Console?\n")
            f.write("  - No need to flash companion firmware\n")
            f.write("  - Change the key on the spot without switching firmware\n")
            f.write("  - Quick if you're comfortable using a console\n")
            f.write("  - Works with MeshCore web console or any terminal app\n\n")
            f.write(f"{'='*70}\n")
            f.write("Troubleshooting\n")
            f.write(f"{'='*70}\n\n")
            f.write("Common Issues:\n")
            f.write("  - Key not appearing: Make sure you tapped the checkmark to save changes\n")
            f.write("  - Wrong key format: Ensure you're copying the entire 128-character\n")
            f.write("    private key\n")
            f.write("  - App not detecting device: Try disconnecting and reconnecting the USB\n")
            f.write("    cable\n")
            f.write("  - Firmware flash fails: Try a different USB cable or USB port\n")
            f.write("  - Key import fails: Verify the key was generated correctly and try again\n\n")
            f.write("Verification Steps:\n")
            f.write("  - Check that the public key displayed matches your generated key\n")
            f.write(f"  - Verify the first characters match your desired prefix: {pattern}\n")
            f.write("  - Test the connection to ensure the device is working properly\n")
            f.write("  - Check the MeshCore network to see your device with the new identifier\n\n")
            f.write("Pro Tip: Keep a backup of your private key in a secure location. You'll\n")
            f.write("need it if you ever need to restore your device configuration.\n")
    
    def load_existing_patterns(self) -> Set[str]:
        """Load already found patterns"""
        existing = set()
        if not self.output_dir.exists():
            return existing
        
        for file in self.output_dir.glob("*.txt"):
            # File format: pattern_1.txt, pattern_2.txt, etc.
            stem = file.stem
            # Remove counter suffix (_1, _2, etc.)
            if '_' in stem:
                parts = stem.rsplit('_', 1)
                if parts[1].isdigit():
                    stem = parts[0]
            existing.add(stem)
        return existing
    
    def run(self, num_workers: int = None) -> None:
        """Start the key search"""
        if num_workers is None:
            num_workers = mp.cpu_count()
        
        existing_patterns = self.load_existing_patterns()
        console = Console()
        
        # Count patterns by length category
        pattern_counts = {5: 0, 6: 0, 7: 0, 8: 0, 9: 0, 10: 0}  # 10 = 10+
        for p in self.patterns:
            plen = len(p)
            if plen <= 5:
                pattern_counts[5] += 1
            elif plen >= 10:
                pattern_counts[10] += 1
            else:
                pattern_counts[plen] += 1
        
        # Count already found (existing) patterns by length
        # Only count patterns that are in the current search list
        existing_counts = {5: 0, 6: 0, 7: 0, 8: 0, 9: 0, 10: 0}
        patterns_upper = {p.upper() for p in self.patterns}
        for p in existing_patterns:
            if p.upper() not in patterns_upper:
                continue  # Skip patterns not in current search list
            plen = len(p)
            if plen <= 5:
                existing_counts[5] += 1
            elif plen >= 10:
                existing_counts[10] += 1
            else:
                existing_counts[plen] += 1
        
        # Build list of remaining pattern lengths (excluding already found)
        # Patterns > max_pattern_length are ALWAYS included (can be found multiple times)
        remaining_pattern_lengths = []
        existing_upper = {ep.upper() for ep in existing_patterns}
        for p in self.patterns:
            plen = len(p)
            # Include if: not found yet OR pattern is longer than max_pattern_length (repeatable)
            if p.upper() not in existing_upper or plen > self.max_pattern_length:
                remaining_pattern_lengths.append(plen)
        
        # Prepare startup info for display process
        startup_info = {
            'num_patterns': len(self.patterns),
            'max_pattern_length': self.max_pattern_length,
            'output_dir': str(self.output_dir.absolute()),
            'num_existing': len(existing_patterns),
            'existing_patterns': ', '.join(sorted(existing_patterns)) if existing_patterns else '',
            'pattern_counts': pattern_counts,
            'existing_counts': existing_counts,
            'remaining_pattern_lengths': remaining_pattern_lengths,
            'verbose': self.verbose
        }
        
        # Shared state
        shared_counter = mp.Value('i', 0)
        shared_found = mp.Value('i', 0)
        manager = mp.Manager()
        found_patterns_dict = manager.dict()
        session_found_list = manager.list()
        shared_patterns = manager.dict()  # Shared patterns for hot-reload
        display_queue = manager.Queue()
        pause_event = mp.Event()
        pause_event.set()
        stop_event = mp.Event()  # For single pattern mode auto-exit
        cpu_limit_event = mp.Event()  # CPU limit toggle (default: off)
        
        # Create individual pause events for each worker
        worker_pause_events = [mp.Event() for _ in range(num_workers)]
        for event in worker_pause_events:
            event.set()  # All workers start running
        
        # Initialize shared patterns
        for pattern in self.patterns:
            shared_patterns[pattern.upper()] = True
        
        for pattern in existing_patterns:
            found_patterns_dict[pattern] = True
        
        start_time = datetime.now().timestamp()
        
        # Pattern hot-reload thread (reload every 30 seconds)
        def pattern_reload_thread():
            if self.single_pattern_mode:
                return  # No reload in single pattern mode
            last_count = len(self.patterns)
            while not stop_event.is_set():
                time.sleep(30)  # Check every 30 seconds
                if stop_event.is_set():
                    break
                try:
                    new_patterns = self.load_patterns(self.patterns_file)
                    added = 0
                    for p in new_patterns:
                        p_upper = p.upper()
                        if p_upper not in shared_patterns:
                            shared_patterns[p_upper] = True
                            added += 1
                    if added > 0:
                        display_queue.put({
                            'patterns_reloaded': True,
                            'new_count': len(shared_patterns),
                            'added': added
                        })
                except Exception:
                    pass  # Ignore reload errors
        
        reload_thread = threading.Thread(target=pattern_reload_thread, daemon=True)
        reload_thread.start()
        
        # Keyboard listener
        def keyboard_listener():
            try:
                import msvcrt
                while True:
                    if msvcrt.kbhit():
                        key = msvcrt.getch().decode('utf-8', errors='ignore').upper()
                        if key == 'P' and pause_event.is_set():
                            pause_event.clear()
                            display_queue.put({'force_update': True})
                        elif key == 'R' and not pause_event.is_set():
                            pause_event.set()
                            display_queue.put({'force_update': True})
                        elif key == 'L':
                            if cpu_limit_event.is_set():
                                cpu_limit_event.clear()
                                # Resume all workers
                                for event in worker_pause_events:
                                    event.set()
                            else:
                                cpu_limit_event.set()
                                # Pause 25% of workers (min 1)
                                workers_to_pause = max(1, int(num_workers * 0.25))
                                for i in range(workers_to_pause):
                                    worker_pause_events[i].clear()
                            display_queue.put({'force_update': True})
                    time.sleep(0.1)
            except Exception:
                pass
        
        kb_thread = threading.Thread(target=keyboard_listener, daemon=True)
        kb_thread.start()
        
        # Start display process
        display_proc = mp.Process(
            target=self.display_process,
            args=(display_queue, self.total_all_time, start_time, num_workers, pause_event, cpu_limit_event, startup_info)
        )
        display_proc.start()
        
        # Start workers
        processes = []
        try:
            for i in range(num_workers):
                p = mp.Process(
                    target=self.generate_and_check_key,
                    args=(i, shared_counter, shared_found, found_patterns_dict,
                          session_found_list, shared_patterns, start_time, display_queue, pause_event,
                          stop_event, worker_pause_events[i], self.single_pattern_mode)
                )
                p.start()
                processes.append(p)
            
            for p in processes:
                p.join()
            
            # Workers finished (single pattern found or all patterns found)
            if stop_event.is_set():
                time.sleep(0.5)  # Let display catch up
                display_queue.put('STOP')
                display_proc.join(timeout=2)
                if display_proc.is_alive():
                    display_proc.terminate()
                
                self.save_total_stats(shared_counter.value)
                
                elapsed = datetime.now().timestamp() - start_time
                keys_per_sec = int(shared_counter.value / elapsed) if elapsed > 0 else 0
                
                # Success Summary
                summary = Table.grid(padding=(0, 2))
                summary.add_column(style="cyan", justify="right")
                summary.add_column(style="bright_white", justify="left")
                
                summary.add_row("Session Keys:", f"[bold green]{shared_counter.value:,}[/bold green]")
                summary.add_row("All-Time Keys:", f"[bold blue]{self.total_all_time + shared_counter.value:,}[/bold blue]")
                summary.add_row("Matches Found:", f"[bold yellow]{shared_found.value}[/bold yellow]")
                summary.add_row("Average Speed:", f"[bold magenta]{keys_per_sec:,} keys/sec[/bold magenta]")
                summary.add_row("Duration:", f"[cyan]{self.format_time(elapsed)}[/cyan]")
                
                if session_found_list:
                    summary.add_row("")
                    summary.add_row("Found Patterns:", f"[bold green]{', '.join(sorted(session_found_list))}[/bold green]")
                
                console.print("\n")
                console.print(Panel(
                    summary,
                    title="[bold green]✓ Pattern Found![/bold green]",
                    border_style="green",
                    padding=(1, 2)
                ))
                console.print("\n")
                return
        
        except KeyboardInterrupt:
            display_queue.put('STOP')
            
            for p in processes:
                p.terminate()
                p.join()
            
            display_proc.join(timeout=2)
            if display_proc.is_alive():
                display_proc.terminate()
            
            self.save_total_stats(shared_counter.value)
            
            elapsed = datetime.now().timestamp() - start_time
            keys_per_sec = int(shared_counter.value / elapsed) if elapsed > 0 else 0
            
            # Summary
            summary = Table.grid(padding=(0, 2))
            summary.add_column(style="cyan", justify="right")
            summary.add_column(style="bright_white", justify="left")
            
            summary.add_row("Session Keys:", f"[bold green]{shared_counter.value:,}[/bold green]")
            summary.add_row("All-Time Keys:", f"[bold blue]{self.total_all_time + shared_counter.value:,}[/bold blue]")
            summary.add_row("Matches Found:", f"[bold yellow]{shared_found.value}[/bold yellow]")
            summary.add_row("Average Speed:", f"[bold magenta]{keys_per_sec:,} keys/sec[/bold magenta]")
            summary.add_row("Duration:", f"[cyan]{self.format_time(elapsed)}[/cyan]")
            
            if session_found_list:
                summary.add_row("")
                summary.add_row("Found Patterns:", f"[bold green]{', '.join(sorted(session_found_list))}[/bold green]")
            
            console.print("\n")
            console.print(Panel(
                summary,
                title="[bold red]⏸️  Search Stopped[/bold red]",
                border_style="red",
                padding=(1, 2)
            ))
            console.print("\n")


def main():
    parser = argparse.ArgumentParser(description='Ed25519 Public Key Pattern Searcher for MeshCore')
    parser.add_argument('--max-pattern-length', type=int, default=int(os.getenv('MAX_PATTERN_LENGTH', '7')))
    parser.add_argument('--patterns-file', '-f', type=str, default=os.getenv('PATTERNS_FILE', 'searchFor.txt'))
    parser.add_argument('--output-dir', type=str, default='found_keys')
    parser.add_argument('--pattern', '-p', type=str, help='Search for a single pattern instead of using patterns file')
    parser.add_argument('--verbose', '-v', action='store_true', help='Show detailed ETA calculation formula')
    
    args = parser.parse_args()
    
    searcher = KeySearcher(
        patterns_file=args.patterns_file,
        output_dir=args.output_dir,
        max_pattern_length=args.max_pattern_length,
        single_pattern=args.pattern,
        verbose=args.verbose
    )
    searcher.run()


if __name__ == "__main__":
    main()
