robrec/RePeter/(commit log)

2025-12-16 Remove obsolete files and add MPPT documentation
    [BOM_RePeter_KernRePeter_2025-12-13.xlsx, ProPrj_KernRePeter_2025-12-13.epro]
2025-12-22 Refactor code structure for improved readability and maintainability
    [BOM_USB-C_Adapter_USB-C_RePeter_V1.xlsx, PickAndPlace_USB-C_RePeter_V1.xlsx]
2025-12-23 Add ESP32 RTC Time Sync functionality with optional OLED display support
2025-12-23 feat: Add RGB LED support and enhance RTC time synchronization with OLED display
    - Implement RGB LED functionality for status indication during setup and synchronization.
    - Update README.md with detailed instructions and features of the ESP32 RTC Time Sync project.
    - Introduce build and flash script for easier deployment using PlatformIO.
    - Add platformio.ini configuration for library dependencies and upload settings.
    - Create .gitignore to exclude build artifacts and system files.
    - Enhance error handling and display messages for better user experience.
    [ESP32_RTC_TimeSync.ino]
2026-01-01 Add Ed25519 Public Key Pattern Searcher script with multi-core support
    - Implemented key searching functionality in key_searcher.py
    - Added README.md for documentation and usage instructions
    - Created .gitignore to prevent accidental uploads of sensitive keys
    - Included search patterns in searchFor.txt for user-defined key searching
    - Ensured secure storage of found keys in the found_keys/ directory
    [key_searcher.py]
2026-01-01 Enhance Ed25519 Public Key Pattern Searcher with Docker support and configurable pattern length
    - Added Docker support for easy deployment and environment isolation
    - Introduced command-line arguments for maximum pattern length and patterns file
    - Updated README.md with Docker installation instructions and usage examples
    - Improved duplicate avoidance logic to support configurable pattern lengths
    - Added .dockerignore to exclude unnecessary files from Docker context
    - Created Dockerfile and docker-compose.yml for container setup
    [key_searcher.py]
2026-01-01 Enhance README and key searcher script: Add per-length ETA timers, session progress tracking, and hot-reload functionality for patterns
2026-01-02 Enhance KeySearcher with regex support and pattern validation
    - Added regex pattern validation and possibility calculation to KeySearcher.
    - Implemented handling for regex patterns in the key search process.
    - Updated the output format for found keys to include effective length and match prefixes.
    - Enhanced the patterns file to support regex patterns alongside plain HEX patterns.
    - Introduced metadata storage for patterns to track found keys and possibilities.
    - Improved user feedback for pattern validation errors and existing keys.
    - Added functionality to sort found keys for regex patterns in the output files.
2026-01-04 Update README: Add links to MCU and correct sensor names
2026-01-04 Refactor code structure and remove redundant code blocks for improved readability and maintainability
    [BOM_RePeter_V1.2_FINISHED_RePeterV1.2_2026-01.xlsx, BOM_USB-C_Adapter_USB-C_RePeter_V1.xlsx, PickAndPlace_USB-C_RePeter_V1.xlsx]
2026-01-04 Update README: Correct entry for V1.2 completion and board order details
2026-01-05 Update README: Refine feature details and enhance clarity for RePeter V1.2
    [BOM_RePeter_V1.2_FINISHED_RePeterV1.2_2026-01-05.xlsx, BOM_RePeter_V1.2_FINISHED_RePeterV1.2_2026-01.xlsx]
2026-01-05 Update LiFePo4 Extension Board image
